Arrogantyunya/Universal_controllerV1.0/通用控制器协议自用.docx

通用控制器协议：

A011：查询LORA主设备的区域以及SN（E011回执当前参数）

单：

组：

A013：设置LORA主设备的区域以及SN（通用回执E020【设置主设备区域及SN成功】）

单：设置该设备区域为xx，SN为xxxxxx

E011：申号

单：

A020：设置某类型接口挂载的某一路子设备及工作组（通用回执E020【设置子设备类型以及工作组成功】）

单：xx区的C002主设备的xx输入输出接口类型的xx设备路数为xx子类型设备，工作组数组为xx。

E020：通用回执指令

单：xx区的C002主设备xx输入输出接口类型的xx设备路数xx状态

A021：查询输入输出接口状态（E021上报设备状态回执）

单：xx区的C002主设备上报自己的状态

E021：上报设备状态回执

单：

A022：设置某路（或某组）输出设备状态（通用回执E020【设置数字/模拟输出设备状态成功】，状态回执E021）

单：xx区域C002主设备的xx输入输出接口类型的xx设备路数设定为xx电平，持续时间为xx

组：xx区域C002主设备的xx组ID的xx子设备类型谁设定为xx电平，持续时间为xx

A023：设置数字输出关联输出状态（通用回执E020【设置关联状态成功】）

单：xx区的C002设备依据设置参数部分进行设置

组：xx区的C002设备依据设置参数部分进行设置0

A024：设置预留字段（通用回执E020【设置预留字段成功】）

单：xx区的C002主设备设置xx字段为xx设定参数

组：xx区的C002主设备设置xx字段为xx设定参数

A025：485设备通讯协议（485回执E025）

单：xx区的xx主设备发送485指令

组：xx区的xx主设备发送485指令

E025：485专用回执

单：
