Arrogantyunya/Universal_controllerV1.0/电磁阀V3.0/电磁阀V3.0_Project.pdf

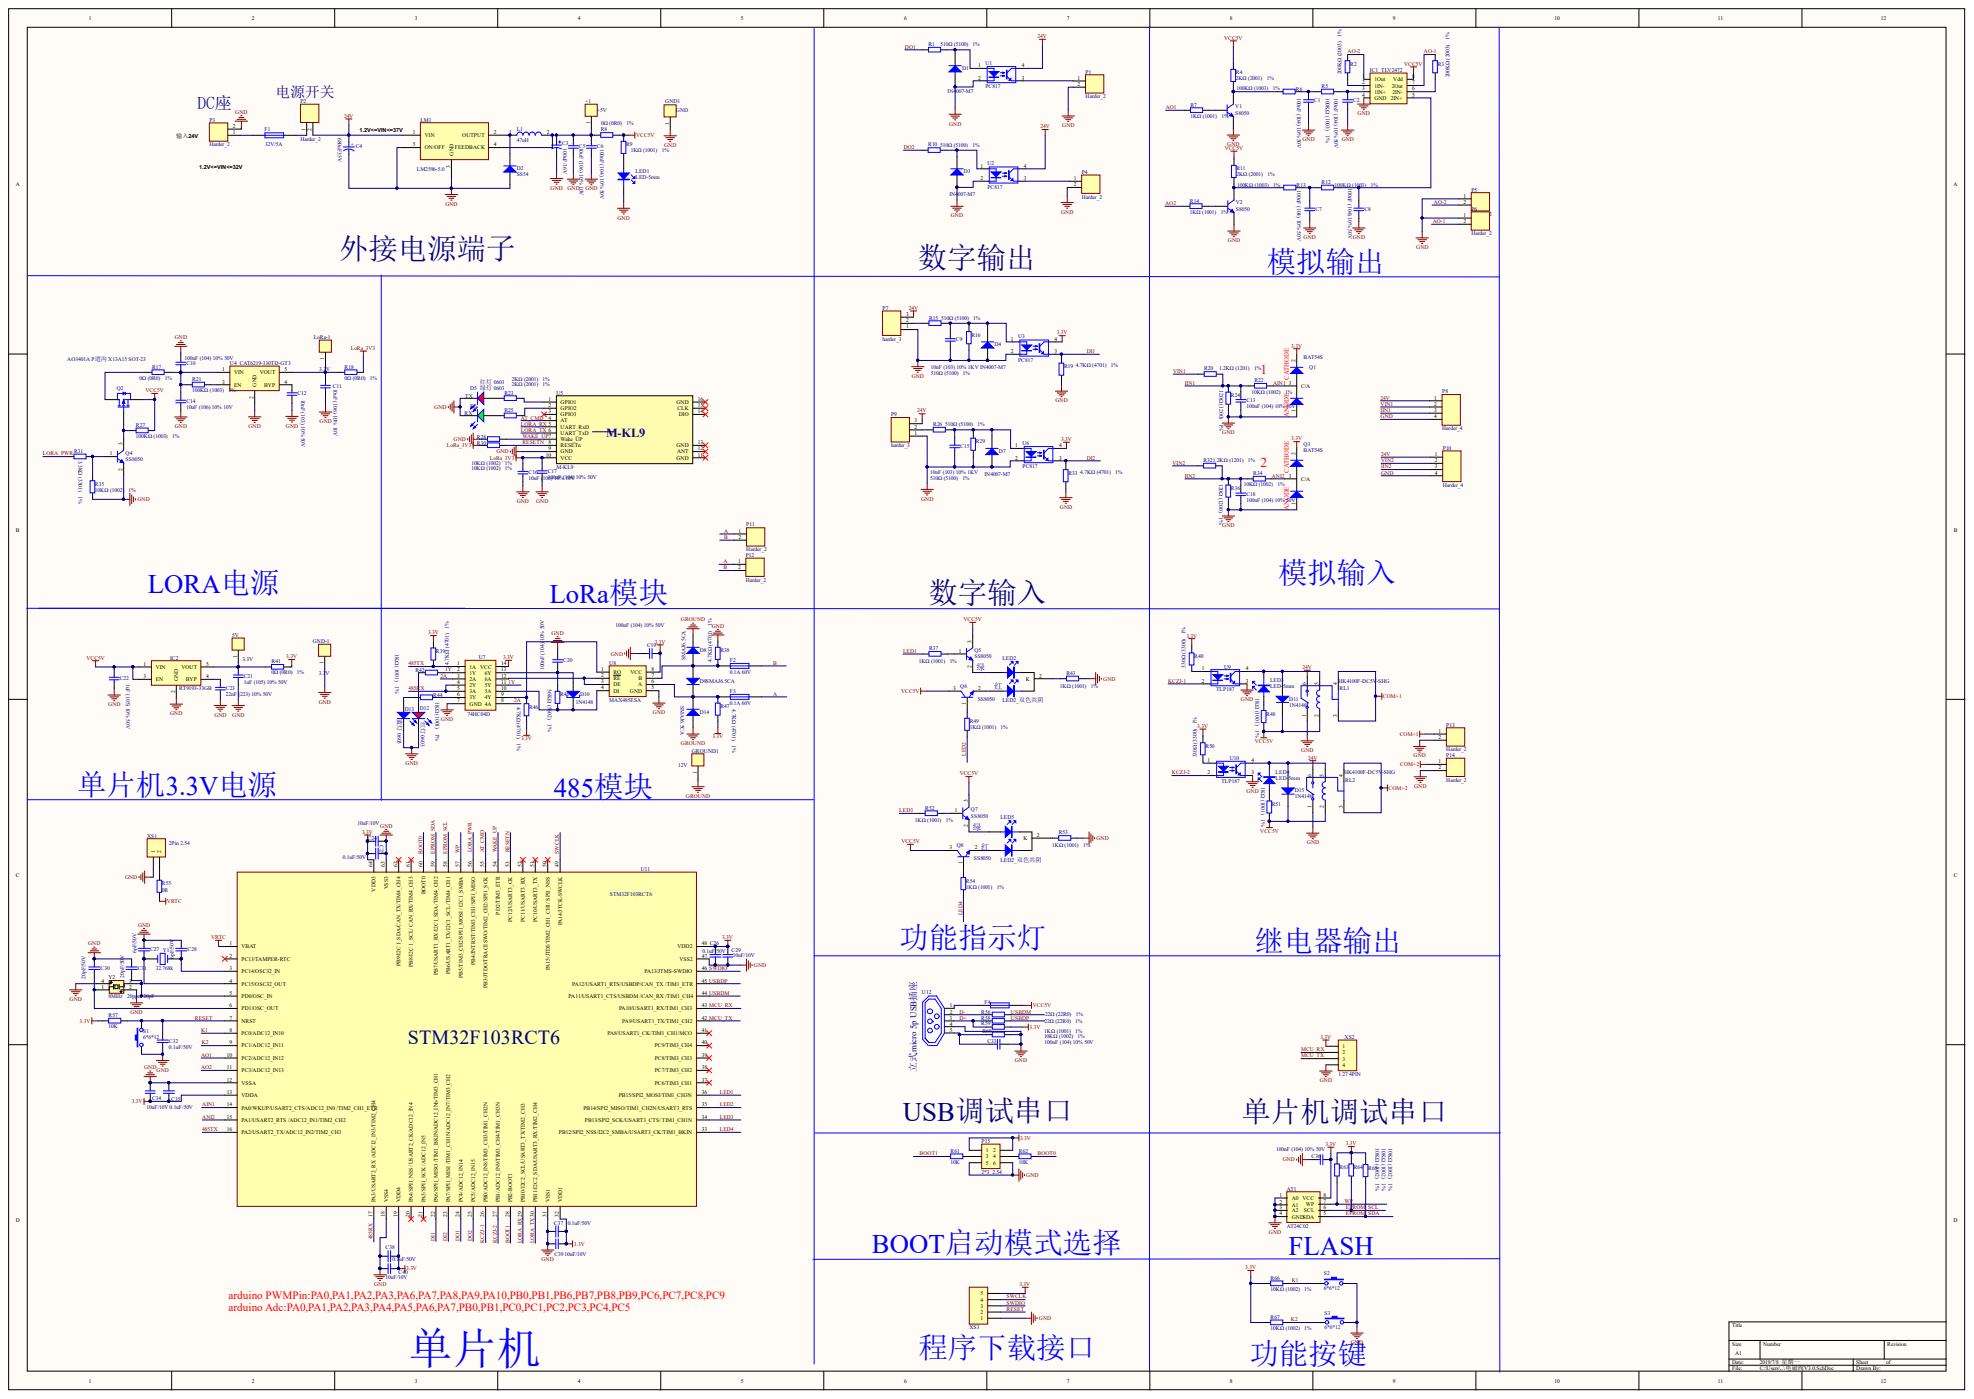
[picture p2: page 1]

Description | Comment | Designator | Footprint | LibRef | Quantity
4R7 功率电感 | 47uH 20% | L1 | SMD,13.8x12.6x7mm | 47uH 20% | 1
路施密特触发反相器 6 | 74HC04D | U7 | SOIC-14_150mil | 74HC14 | 1
发光二极管 | 红灯 0603 | D5, D12 | LC-0603_LED_S1 | 0603 红灯 | 2
发光二极管 | 绿灯 0603 | D6 | LC-0603_LED_S1 | 0603 绿灯 | 1
发光二极管 | 蓝灯 0603 | D13 | LC-0603_LED_S1 | 0603 蓝灯 | 1
贴片电阻 | 0Ω (0R0) 1% | R8, R17, R18, R41 | LC-0603_R | 0603 0Ω (0R0) 1% | 4
贴片电阻 | 1KΩ (1001) 1% | R7, R9, R14, R37, R42, R43, R44, R48, R49, R51, R52, R53, R54, R59 | LC-0603_R | 0603 1KΩ (1001) 1% | 14
贴片电容 | 1uF (105) 10%50V | C21, C22 | LC-0603_C | 0603 1uF (105) 10%50V | 2
贴片电阻 | 1.2KΩ (1201) 1% | R20, R32 | LC-0603_R | 0603 1.2KΩ (1201) 1% | 2
贴片电阻 | 2KΩ (2001) 1% | R4, R11, R23, R25 | LC-0603_R | 0603 2KΩ (2001) 1% | 4
贴片电阻 | 3.3KΩ (3301) 1% | R31 | LC-0603_R | 0603 3.3KΩ (3301) 1% | 1
贴片电阻 | 4.7KΩ (4701) 1% | R19, R33, R38, R39, R46, R47 | LC-0603_R | 0603 4.7KΩ (4701) 1% | 6
贴片电阻 | 10KΩ (1002) 1% | R22, R28, R30, R34, R35, R60, R63, R64, R65, R66, R67 | LC-0603_R | 0603 10KΩ (1002) 1% | 11
贴片电容 | 10nF (103) 10%50V | C12 | LC-0603_C | 0603 10nF (103) 10% 50V | 1
贴片电容 | 10uF (106) 10%10V | C5, C11, C14, C16 | LC-0603_C | 0603 10uF (106) 10% 10V | 4
贴片电容 | 22nF (223) 10%50V | C23 | LC-0603_C | 0603 22nF (223) 10% 50V | 1
贴片电阻 | 22Ω (22R0) 1% | R56, R58 | LC-0603_R | 0603 22Ω (22R0) 1% | 2
贴片电阻 | 56KΩ (5602) 1% | R45 | LC-0603_R | 0603 56KΩ (5602) 1% | 1
贴片电容 | 10nF (103) 10%1KV | C9, C15 | LC-1206_C | 1206 10nF (103) 10% 50V | 2
贴片电阻 | 100KΩ (1003) 1% | R5, R6, R12, R13, R21, R27 | LC-0603_R | 0603 100KΩ (1003) 1% | 6
贴片电容 | 100nF (104) 10%50V | C1, C2, C6, C7, C8, C10, C13, C17, C18, C19, C20, C33, C36 | LC-0603_C | 0603 100nF (104) 10% 50V | 13
贴片电阻 | 120Ω (1200) 1% | R24, R36 | LC-0603_R | 0603 120Ω (1200) 1% | 2
贴片电阻 | 200KΩ (2003) 1% | R2, R3 | LC-0603_R | 0603 200KΩ (2003) 1% | 2
贴片电阻 | 330Ω (3300) 1% | R40, R50 | LC-0603_R | 0603 330Ω (3300) 1% | 2
贴片电阻 | 510Ω (5100) 1% | R1, R10, R15, R16, R26, R29 | LC-0603_R | 0603 510Ω (5100) 1% | 6
MOS( 场效应管 ) | AO3401A P SOT-23 道沟 X13A15 | Q2 | LC-SOT-23-3L | AO3401A P 道沟 X13A15 SOT-23 | 1
| AT24C02 | AT1 | AT24C02 | AT24C02 | 1
肖特基二极管 | BAT54S | Q1, Q3 | SOT-23-3 | BAT54S | 2
直插电解电容 | 100uF/ 16V | C3 | CAP5*X | Ca | 1
贴片电容 | 0.1uF/ 50V | C25, C26, C32, C35, C37, C38 | C-0603 | CAP | 6
贴片电容 | 10uF/ 10V | C24, C29, C34, C39, C40 | C-0603 | Cap | 5
贴片电容 | 20pF/ 50V | C30, C31 | C-0603 | CAP | 2
贴片电容 | 6pF/ 50V | C27, C28 | C-0603 | CAP | 2
| 680uF35V | C4 | C10x16 | CAP_DIP | 1
CAT6219 | CAT6219-330TD-GT3 | U4 | SOT23-5 | CAT6219 | 1
低压差线性稳压 (LDO) | RT9193-33GB | IC2 | SOT23-5 | CAT6219 | 1
Crystal | 32.768k | Y1 | 3215_32.768K | CRYSTAL | 1
通用二极管 | SMAJ6.5CA | D8, D9, D14 | DO-214AC | Diode | 3
二极管 | IN4007-M7 | D1, D3, D4, D7 | DO-214AC | Diode 1N4001 | 4
稳压二极管 | 1N4148 | D10 | LL-34 | Diode Zener | 1
贴片保险丝 | 32V/ 5A | F1, F4 | Fuse-1206 | Fuse | 2
贴片保险丝 0.1A 60V | 0.1A 60V | F2, F3 | R-1812 | Fuse_1 | 2
| Harder_2 | P1, P2, P3, P4, P5, P6, P11, P12, P13, P14 | 2Pin-2.54A | Harder_2 | 10
| harder_3 | P7, P9 | 3PIN-2.54 | harder_3 | 2
| Harder_4 | P8, P10 | 4PIN-2.54 A | Harder_4 | 2
1.27 卧式贴片针座 | 1.27 4PIN | XS2 | JXT-4 | Hea | 1
双排插针 | 2*3 2.54 | P15 | 201S2X3 | Header 2*3 | 1
单排插针 | 2Pin 2.54 | XS1 | JXT-2 | Header 2H | 1
卧式贴片针座 1.27 | Header 2.54X4 | XS3 | JXT-5 | Header 5 | 1
继电器 | HK4100F-DC5V-SHG | RL1, RL2 | HK4100F-DC5V-SHG | HK4100F-DC5V-SHG | 2
| LED2_ 双色共阴 | LED2, LED5 | 双色 LED | LED2_ 双色共阴 | 2
发光二极管 | LED-5mm | LED1, LED3, LED4 | LED_5mm | LED-5mm | 3
LM2596-5.0 | LM2596-5.0 | LM1 | LC-TO-263-5 | LM2596 | 1
| M-KL9 | U5 | M-KL9 | M-KL9 | 1
RS485 收发芯片 | MAX485ESA | U8 | SOP-8_150mil | MAX485ESA | 1
NPN 三极管 | S8050 | V1, V2 | SOT-23-3 | NPN | 2
光藕 | PC817 | U1, U2, U3, U6 | LC-SMD-4 | PC817 | 4
光藕 | TLP187 | U9, U10 | TLP187 - duplicate | Q817 | 2
贴片电阻 | 0R | R55 | R-0603 | Res2 | 1
贴片电阻 | 10K | R57, R61, R62 | R-0603 | Res2 | 3
二极管 | SS54 | D2 | LC-SMA(DO-214AC)_S1 | SMA(DO-214AC) SS54 | 1
贴片晶振 | 8MHz 20ppm 20pF | Y2 | LC-SMD-5032_4P | SMD-5032_4P 8MHz 20ppm 20pF | 1
NPN 贴片三极管 | SS8050 | Q4, Q5, Q6, Q7, Q8 | SOT-23 | SS8050 | 5
单片机 | STM32F103RCT6 | U11 | LQFP-64_10x10x05P | STM32F103RCT6 | 1
侧脚带支架 微型按键 | 6*6*12 | S1, S2, S3 | KEY-7.0*7.0 | SW-PB_4 | 3
测试点 | +5V | +1 | TEST_POINT | TEST_POINT | 1
测试点 | 12V | GROUND1 | TEST_POINT | TEST_POINT | 1
测试点 | 3.3V | 5V, GND-1, LoRa-1 | TEST_POINT | TEST_POINT | 3
测试点 | GND | GND1 | TEST_POINT | TEST_POINT | 1
输出放大 | TLV2472 | IC1 | SOP8 | TLV2472 | 1
| 立式 micro 5p USB 插座 | U12 | USB 插座 micro 5p | USB_micro_5p | 1
开关二极管 | 1N4148 | D11, D15 | SOD-123 | 开关二极管 | 2
