Arrogantyunya/Universal_controllerV1.0/(list of files, drawings)

Other design files:
电磁阀V3.0/电磁阀V3.0.SchDoc
电磁阀V3.0/电磁阀V3.0_Project.PrjPcb
