Arrogantyunya/Universal_controllerV1.0/Universal_controller/user_A011_E011.cpp

//user_A011_E011.cpp
/*
*版权
*
* 文件名称:user_A011_E011.cpp
* 文件标识:配置管理计划书
* 摘要:
*
* 当前版本:V1.0
* 作者:刘家辉
* 完成日期:
* 修改者:
* 修改日期:
*
* 取代版本:
* 原作者:刘家辉
* 完成日期:
*/

#include "user_A011_E011.h"
#include "user_initialization.h"


//函 数 名：Receive_A011() 
//功能描述：A011的执行函数
//函数说明：查询LORA主设备的区域以及SN
//调用函数：
//全局变量：
//输 入：
//返 回：
/////////////////////////////////////////////////////////////////////
void Receive_A011(unsigned char * Judgement_Data, int Judgement_Length)//A011函数
{

	//--------------------------------------------------------
	//该区域为测试传输进Receive_A011函数的数据是否正确的测试代码块
	//需要测试时请取消注释
	if (debug ==1)
	{
		Serial.println("进入Receive_A011函数");
		for (int i = 0; i < Judgement_Length + 1; i++)
		{
			Serial.print("A011Judgement_Data ");
			Serial.print(i);
			Serial.print(" :");
			Serial.println(Judgement_Data[i], HEX);
			delay(1);
		}
		delay(500);
		Serial.print("Judgement_Length = ");
		Serial.println(Judgement_Length);
	}
	//--------------------------------------------------------
	//int ZoneID = Judgement_Data[7];
	//if (debug == 1)
	//{
	//	Serial.println(ZoneID, HEX);
	//}
	//AT24CXX_WriteOneByte(12, ZoneID);//将区域ID写入数组
	//for (size_t i = 8; i <= 16; i++)
	//{
	//	AT24CXX_WriteOneByte(i - 5, Judgement_Data[i]);
	//	if (debug == 1)
	//	{
	//		Serial.print(String("AT24CXX_ReadOneByte[ ") + String(i-5) + String(" ]="));
	//		Serial.println(AT24CXX_ReadOneByte(i - 5), HEX);
	//	}
	//}

	//是否广播指令
	Receive_IsBroadcast = Judgement_Data[6];

	//进行状态的回执
	Send_E011(Receive_IsBroadcast);
	if (debug == 1)
	{
		Serial.println("完成A011状态回执");
		Serial.println("结束Receive_A011函数");
	}
}


//函 数 名：Send_E011() 
//功能描述：
//函数说明：A011帧的函数
//调用函数：
//全局变量：
//输 入：
//返 回：
/////////////////////////////////////////////////////////////////////
unsigned char Send_E011(int Receive_IsBroadcast)//E011函数
{

	E011_init();//E011初始化函数

	E011_IsBroadcast = Receive_IsBroadcast;//E011的是否广播指令

	E011[0] = E011_FrameHead;
	E011[1] = E011_FrameId1;
	E011[2] = E011_FrameId2;
	E011[3] = E011_DataLen;
	E011[4] = E011_DeviceTypeID1;
	E011[5] = E011_DeviceTypeID2;
	E011[6] = E011_IsBroadcast;
	E011[7] = E011_ZoneId;
	E011[8] = E011_DeviceSN1;
	E011[9] = E011_DeviceSN2;
	E011[10] = E011_DeviceSN3;
	E011[11] = E011_DeviceSN4;
	E011[12] = E011_DeviceSN5;
	E011[13] = E011_DeviceSN6;
	E011[14] = E011_DeviceSN7;
	E011[15] = E011_DeviceSN8;
	E011[16] = E011_DeviceSN9;
	for (size_t i = 4; i <= E011_DataLen + 0x03; i++)
	{
		Check_Data[Check_Length] = E011[i];
		// Check_Data[Check_Length] = 0x55;
		if (debug == 1)
		{
			Serial.print("Check_Data ");
			Serial.print(Check_Length);
			Serial.print(" :");
			Serial.println(Check_Data[Check_Length], HEX);
		}
		Check_Length++;
		delay(1);
	}
	Serial.print("Check_Length = ");
	Serial.println(Check_Length);

	if (Check_Length > 0)
	{
		E011_CRC8 = GetCrc8(Check_Data, Check_Length);//得到CRC数据
		if (debug == 1)
		{
			Serial.print("CRC8计算的值E011_CRC8 = 0x");
			Serial.println(E011_CRC8, HEX);
		}
		Check_Length = 0;
	}
	E011[17] = E011_CRC8;
	E011[18] = E011_FrameEnd1;
	E011[19] = E011_FrameEnd2;
	E011[20] = E011_FrameEnd3;
	E011[21] = E011_FrameEnd4;
	E011[22] = E011_FrameEnd5;
	E011[23] = E011_FrameEnd6;

	//该区域为串口查看E011回执的信息
	if (debug == 1)
	{
		for (int i = 0; i < 24; i++)
		{
			Serial.print(i);
			Serial.print("/");
			Serial.println(E011[i], HEX);
			delay(1);
		}
	}

	Serial3.write(E011, 24);
	Serial3.flush();
	Send_Data_Lamp();//发送数据灯
	return 0;
}

//函 数 名：E011_init() 
//功能描述：
//函数说明：E011初始化函数
//调用函数：
//全局变量：
//输 入：
//返 回：
/////////////////////////////////////////////////////////////////////
unsigned char E011_init()
{
	E011_FrameHead = 0xFE;                  //E011的帧头

	E011_FrameId1 = 0xE0;                   //E011的帧ID1
	E011_FrameId2 = 0x11;                   //E011的帧ID2

	E011_DataLen = 0x0D;                    //E011的数据长度

	E011_DeviceTypeID1 = 0xC0;				//E011的设备类型1
	E011_DeviceTypeID2 = 0x02;				//E011的设备类型2

	E011_IsBroadcast = Receive_IsBroadcast;//E011的是否广播指令

	E011_ZoneId = AT24CXX_ReadOneByte(12);         //E011的区域

	E011_DeviceSN1 = AT24CXX_ReadOneByte(3);       //E011的SN1
	E011_DeviceSN2 = AT24CXX_ReadOneByte(4);       //E011的SN2
	E011_DeviceSN3 = AT24CXX_ReadOneByte(5);       //E011的SN3
	E011_DeviceSN4 = AT24CXX_ReadOneByte(6);       //E011的SN4
	E011_DeviceSN5 = AT24CXX_ReadOneByte(7);       //E011的SN5
	E011_DeviceSN6 = AT24CXX_ReadOneByte(8);       //E011的SN6
	E011_DeviceSN7 = AT24CXX_ReadOneByte(9);       //E011的SN7
	E011_DeviceSN8 = AT24CXX_ReadOneByte(10);      //E011的SN8
	E011_DeviceSN9 = AT24CXX_ReadOneByte(11);      //E011的SN9

	E011_CRC8 = 0x00;                       //E011的CRC8校验码

	E011_FrameEnd1 = 0x0D;                  //E011的帧尾1
	E011_FrameEnd2 = 0x0A;                  //E011的帧尾2
	E011_FrameEnd3 = 0x0D;                  //E011的帧尾3
	E011_FrameEnd4 = 0x0A;                  //E011的帧尾4
	E011_FrameEnd5 = 0x0D;                  //E011的帧尾5
	E011_FrameEnd6 = 0x0A;                  //E011的帧尾6
}
