Arrogantyunya/Universal_controllerV1.0/(commit log)

2019-08-14 通用控制器的初始代码
    [电磁阀V3.0.SchDoc, 电磁阀V3.0_Project.PrjPcb]
2019-08-14 遇到了string转换为数组的问题
2019-08-14 重新使用数组接收LORA串口数据
2019-08-15 完成了文件的基本框架
2019-08-15 完成了A103的设置功能
2019-08-16 完成了A020的设置，遗留了E021的问题
2019-08-16 解决E021回执数字状态的问题，未解决E021回执模拟状态的问题
2019-08-17 A022的模拟输出设置问题未解决
2019-08-17 A022的组播功能未解决
2019-08-19 剩余A023,A024未适配
2019-08-20 剩余A023设置策略未完成
2019-08-21 剩余关联的逻辑未理清思路怎么实现
2019-08-22 2019-8-22,未解决策略问题
2019-08-23 完成了自动策略条件逻辑判断的基本框架，执行语句未完成
2019-08-26 完善了一部分自动策略的执行
2019-08-27 发现了LORA传输数据的问题
2019-08-27 未解决LORA传输数据的问题
2019-08-29 通过在策略执行时调用LORA接收暂时解决LORA接收数据不完整的问题
2019-08-29 对策略的判断条件以及执行进行了补充
2019-08-29 对LOOP循环的代码封装函数
